noorul23/autocrash-sos-final/images/pcb_backside.jpg

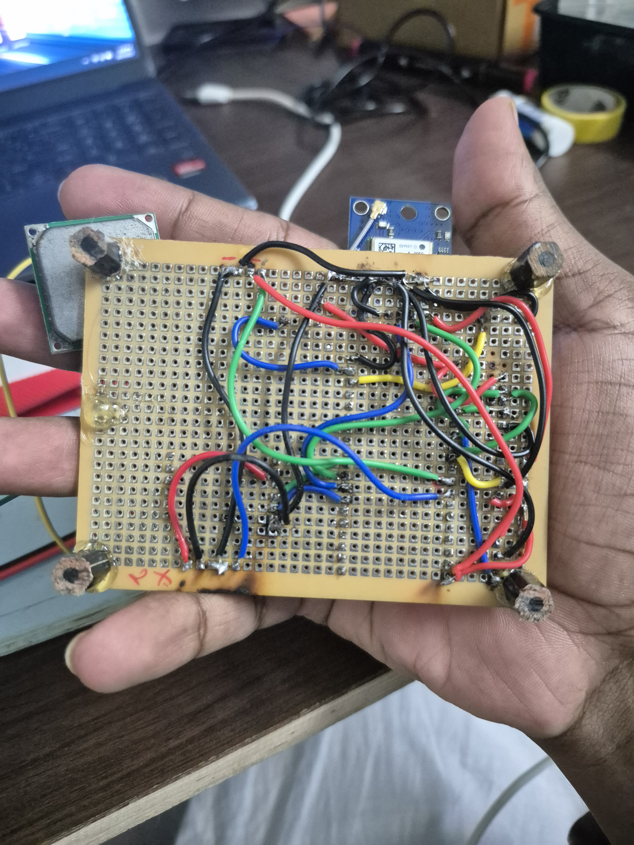
[picture p6: images/pcb_backside.jpg]
images/pcb_backside.jpg
